ChristianBuechel/Artisan_Roaster_Arduino/circuit.jpg

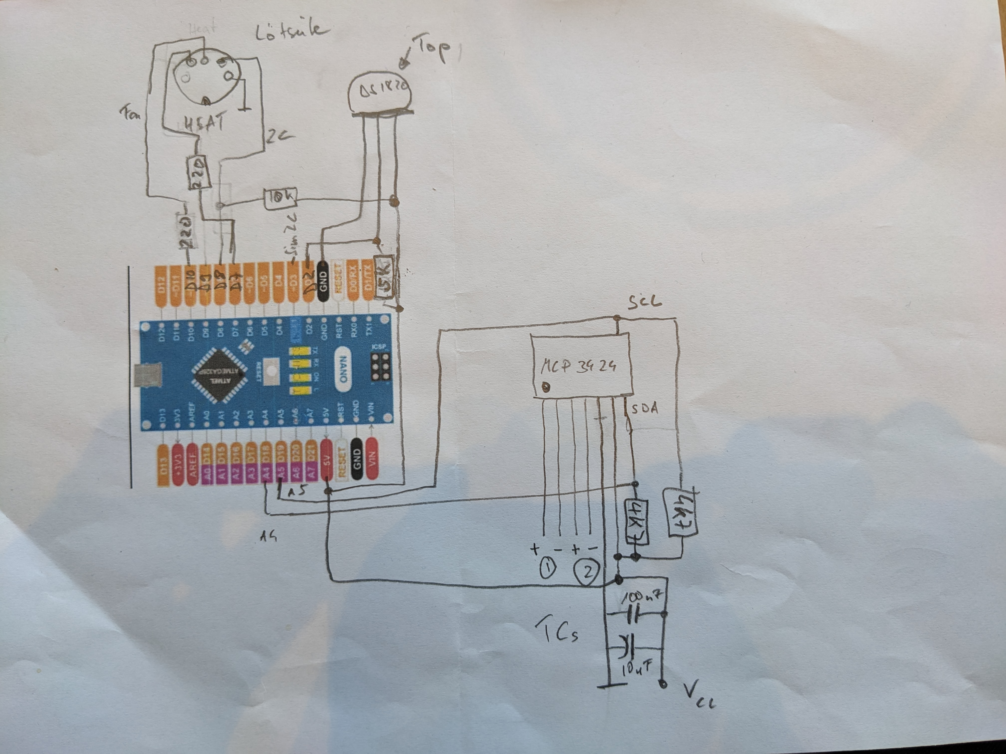
circuit.jpg
